PaFDC/CTS-Maker-Kit-Hardware/README.md

# CTS-Maker-Kit-Hardware
PCB and schematics for the Capacitive Touch Sensor Maker Kit.
