PaFDC/CTS-Maker-Kit-Hardware/PCB/Teensy_Board.png

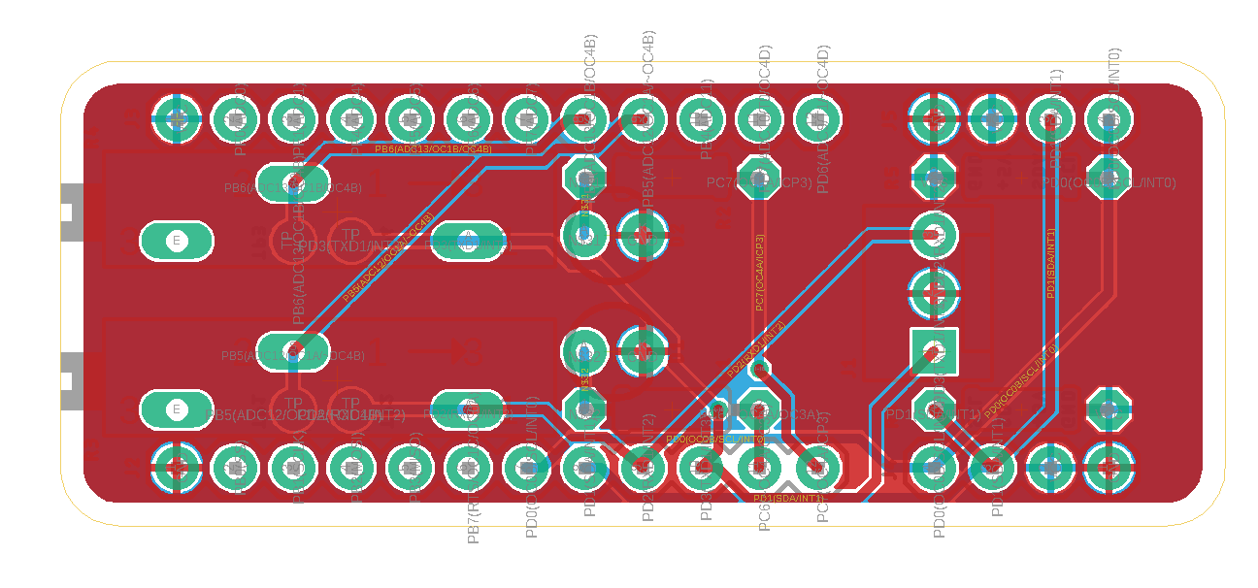
PCB/Teensy_Board.png
