PaFDC/CTS-Maker-Kit-Hardware/BOM/BOM_CTS_Teensy_Board_v1_1.xlsx

Part | Value | Device | Package | Description | PROD_ID | SF_ID | TP_SIGNAL_NAME | Vendor | Part Number | URL
D1 | RED | LED3MM | LED_3MM | LED (Generic) | DIO-08794 |  |  | Digikey | 732-5013-ND | https://www.digikey.com/product-detail/en/wurth-electronics-inc/151033RS03000/732-5013-ND/4490003
D2 | BLUE | LED3MM | LED_3MM | LED (Generic) | DIO-08794 |  |  | Digikey | 732-5011-ND | https://www.digikey.com/product-detail/en/wurth-electronics-inc/151033BS03000/732-5011-ND/4489997
J1 | 1x3 MOLEX KK-156 RIGHT ANGLE | CONN_03POLAR | MOLEX-1X3 | Multi connection point. Often used as Generic Header-pin footprint for 0.1 inch spaced/style header connections | CONN-08625 | PRT-08096 |  | Tayda Electronics | A-816 | https://www.taydaelectronics.com/wafer-connector-2-54mm-3-pins-right-angle.html
J2 | 1x12 FEMALE | CONN_12 | 1X12 | Multi connection point. Often used as Generic Header-pin footprint for 0.1 inch spaced/style header connections |  |  |  | Digikey | S7045-ND | https://www.digikey.com/product-detail/en/sullins-connector-solutions/PPPC121LFBN-RC/S7045-ND/810184
J3 | 1x12 FEMALE | CONN_12 | 1X12 | Multi connection point. Often used as Generic Header-pin footprint for 0.1 inch spaced/style header connections |  |  |  | Digikey | S7045-ND | https://www.digikey.com/product-detail/en/sullins-connector-solutions/PPPC121LFBN-RC/S7045-ND/810184
J4 | 1x4 MALE | CONN_04 | 1X04 | Multi connection point. Often used as Generic Header-pin footprint for 0.1 inch spaced/style header connections | CONN-09696 |  |  | Digikey | S1112EC-02-ND | https://www.digikey.com/product-detail/en/sullins-connector-solutions/PREC002SBAN-M71RC/S1112EC-02-ND/2774932
J5 | 1x4 MALE | CONN_04 | 1X04 | Multi connection point. Often used as Generic Header-pin footprint for 0.1 inch spaced/style header connections | CONN-09696 |  |  | Digikey | S1112EC-02-ND | https://www.digikey.com/product-detail/en/sullins-connector-solutions/PREC002SBAN-M71RC/S1112EC-02-ND/2774932
R1 | 150 | R-US_0204/7 | 0204/7 | RESISTOR, American symbol |  |  |  | Digikey | S150CACT-ND | https://www.digikey.com/product-detail/en/stackpole-electronics-inc/RNMF14FTC150R/S150CACT-ND/2617812
R2 | 100 | R-US_0204/7 | 0204/7 | RESISTOR, American symbol |  |  |  | Digikey | S100CACT-ND | https://www.digikey.com/products/en?keywords=S100CACT-ND
R3 | 1M | TRIM_US-B90P | SP19L | POTENTIOMETER |  |  |  | Digikey | 3006P-105LF-ND | https://www.digikey.com/product-detail/en/bourns-inc/3006P-1-105LF/3006P-105LF-ND/1087573
R4 | 1M | TRIM_US-B90P | SP19L | POTENTIOMETER |  |  |  | Digikey | 3006P-105LF-ND | https://www.digikey.com/product-detail/en/bourns-inc/3006P-1-105LF/3006P-105LF-ND/1087573
R5 | 4.7K | R-US_0204/7 | 0204/7 | RESISTOR, American symbol |  |  |  | Digikey | S4.7KCACT-ND | https://www.digikey.com/product-detail/en/stackpole-electronics-inc/RNMF14FTC4K70/S4.7KCACT-ND/2617510
R6 | 4.7K | R-US_0204/7 | 0204/7 | RESISTOR, American symbol |  |  |  | Digikey | S4.7KCACT-ND | https://www.digikey.com/product-detail/en/stackpole-electronics-inc/RNMF14FTC4K70/S4.7KCACT-ND/2617510
