PaFDC/CTS-Maker-Kit-Hardware/PCB/CTS_Teensy_Board_v1_1.brd

## EAGLE design PCB/CTS_Teensy_Board_v1_1.brd (2019-08-05)

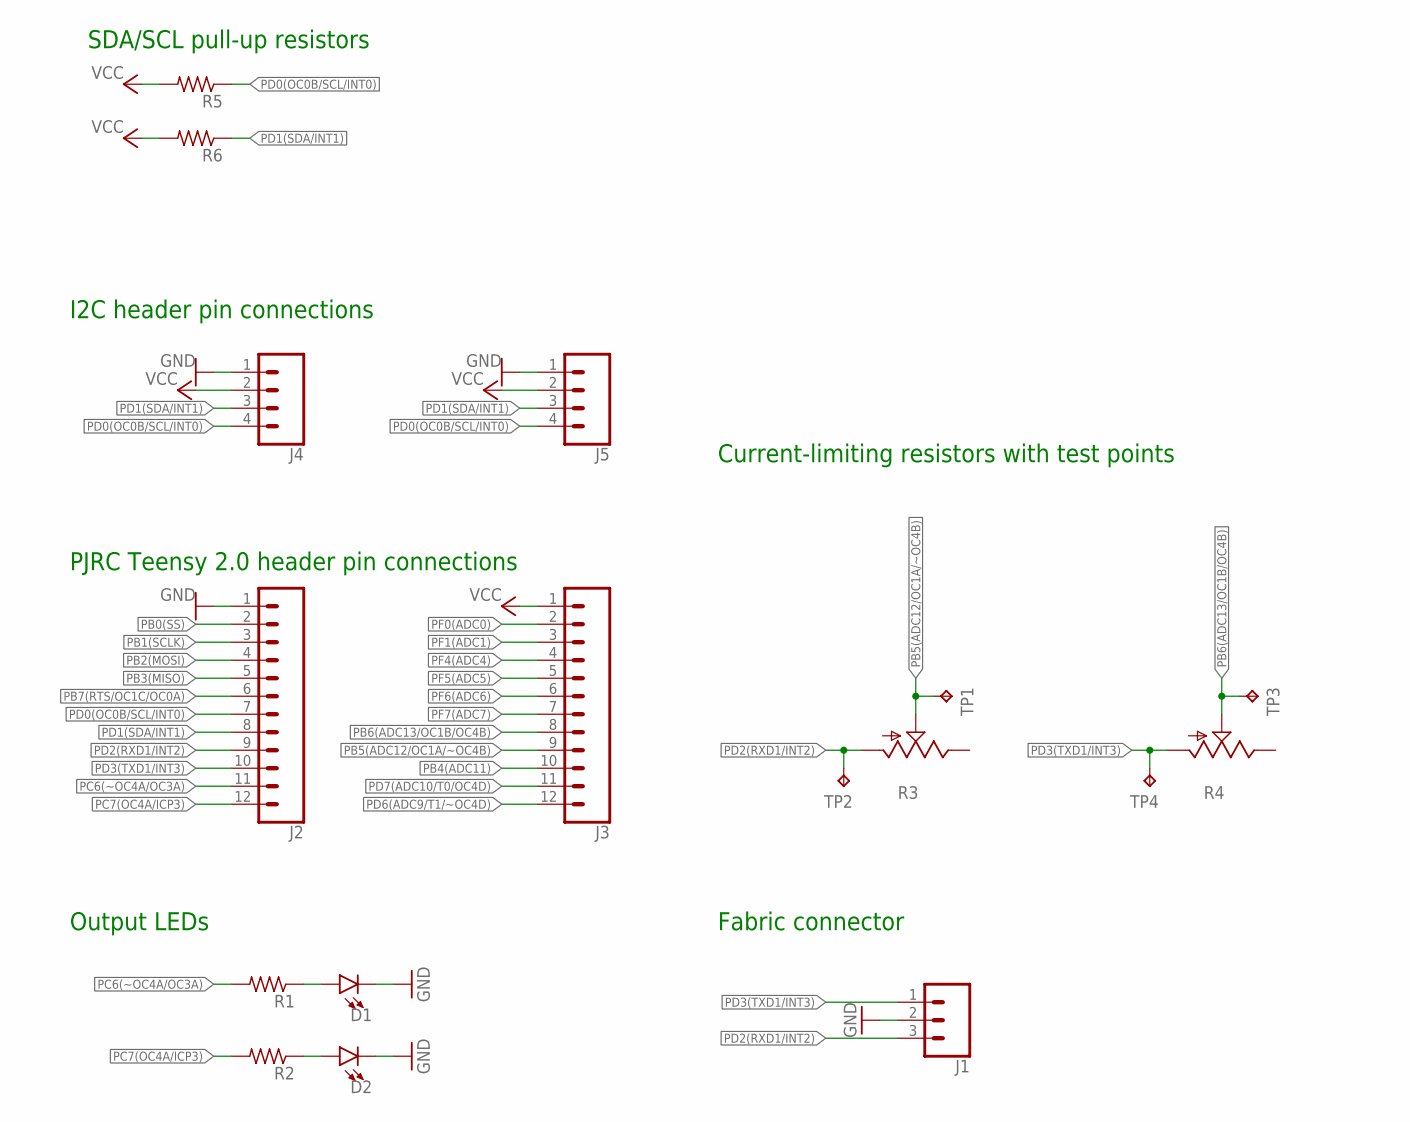
[picture p2: schematic CTS_Teensy_Board_v1_1.sch]

Parts:
D1, D2: LED3MM; LED_3MM
J1: CONN_03POLAR; MOLEX-1X3
J2, J3: CONN_12; 1X12
J4, J5: CONN_04; 1X04
R1, R2, R5, R6: R-US_0204/7; 0204/7
R3, R4: TRIM_US-B90P; SP19L
TP1, TP2, TP3, TP4: TPTP18R; TP18R

Connections:
GND: D1.K (C), D2.K (C), J1.2, J2.1, J4.1, J5.1
unnamed: D2.A, R2.1
unnamed: D1.A, R1.1
PB0(SS): J2.2
PB1(SCLK): J2.3
PB2(MOSI): J2.4
PB3(MISO): J2.5
PB4(ADC11): J3.10
PB5(ADC12/OC1A/~OC4B): J3.9, R3.S, TP1.TP
PB6(ADC13/OC1B/OC4B): J3.8, R4.S, TP3.TP
PB7(RTS/OC1C/OC0A): J2.6
PC6(~OC4A/OC3A): J2.11, R1.2
PC7(OC4A/ICP3): J2.12, R2.2
PD0(OC0B/SCL/INT0): J2.7, J4.4, J5.4, R5.1
PD1(SDA/INT1): J2.8, J4.3, J5.3, R6.1
PD2(RXD1/INT2): J1.3, J2.9, R3.A, TP2.TP
PD3(TXD1/INT3): J1.1, J2.10, R4.A, TP4.TP
PD6(ADC9/T1/~OC4D): J3.12
PD7(ADC10/T0/OC4D): J3.11
PF0(ADC0): J3.2
PF1(ADC1): J3.3
PF4(ADC4): J3.4
PF5(ADC5): J3.5
PF6(ADC6): J3.6
PF7(ADC7): J3.7
VCC: J3.1, J4.2, J5.2, R5.2, R6.2

Notes on the sheet:
SDA/SCL pull-up resistors
I2C header pin connections
PJRC Teensy 2.0 header pin connections
Current-limiting resistors with test points
Output LEDs
Fabric connector

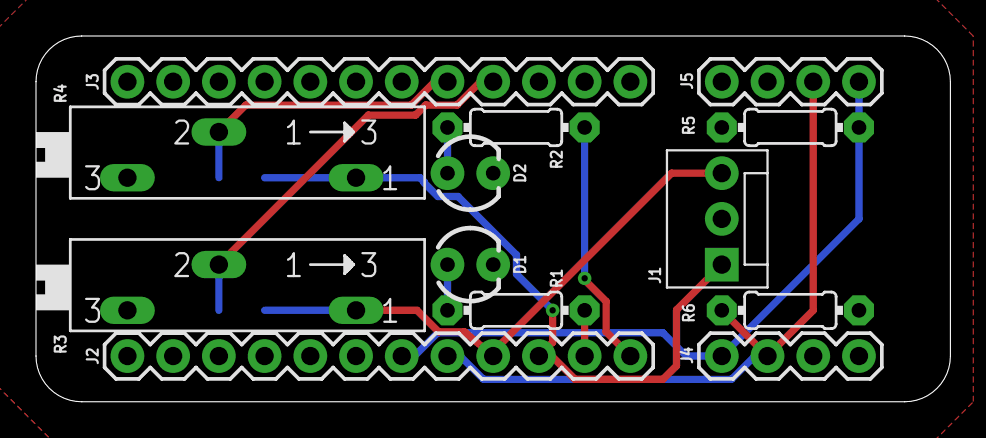
[picture p3: board CTS_Teensy_Board_v1_1.brd from above]

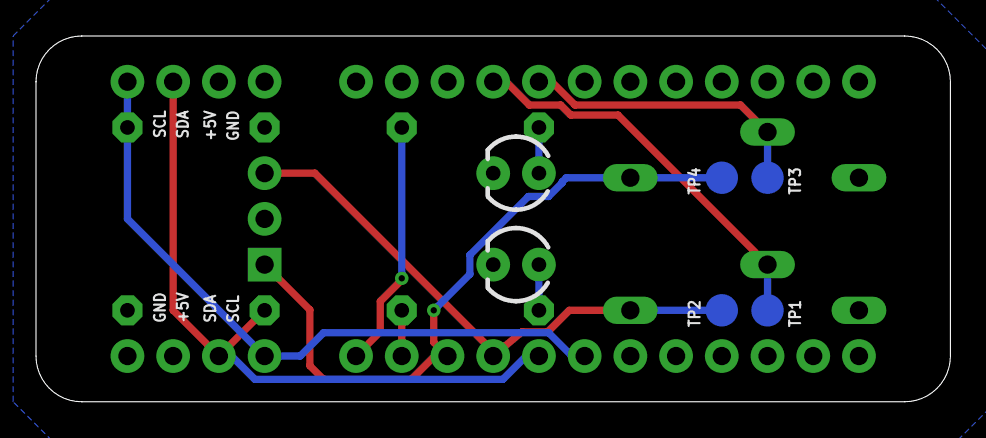
[picture p4: board CTS_Teensy_Board_v1_1.brd from below]

Board: 2 copper layers, 50.8 x 20.3 mm, 17 parts (4 on the bottom side), 12 nets.
