PaFDC/CTS-Maker-Kit-Hardware/(commit log)

2019-08-05 Added BOM as .xlsx and .htm
    [BOM_CTS_Teensy_Board_v1_1.xlsx]
2019-08-05 Added BOM, schematics, and docs
    [BOM_CTS_Teensy_Board_v1_1.xlsx, CTS_Teensy_Board_v1_1.brd, CTS_Teensy_Board_v1_1.sch]
